rjafari44/Wall-Climber-Robot/cadFiles/frame.stl

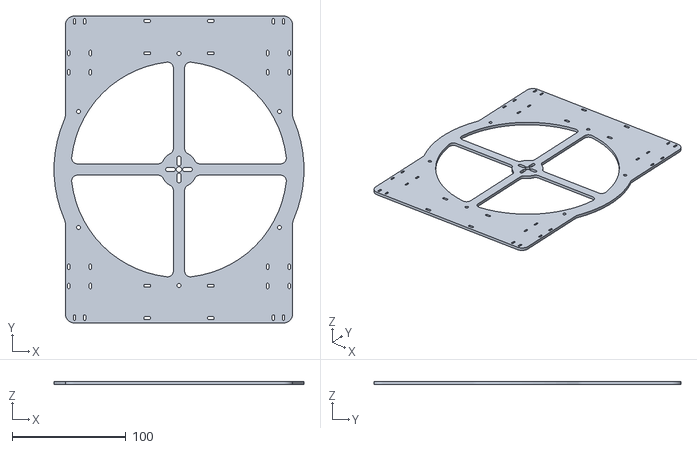
[picture p4: CAD file, 2026-03-28]
cadFiles/frame.stl
220.0 x 270.0 x 3.00
