rjafari44/Wall-Climber-Robot/cadFiles/shroud.stl

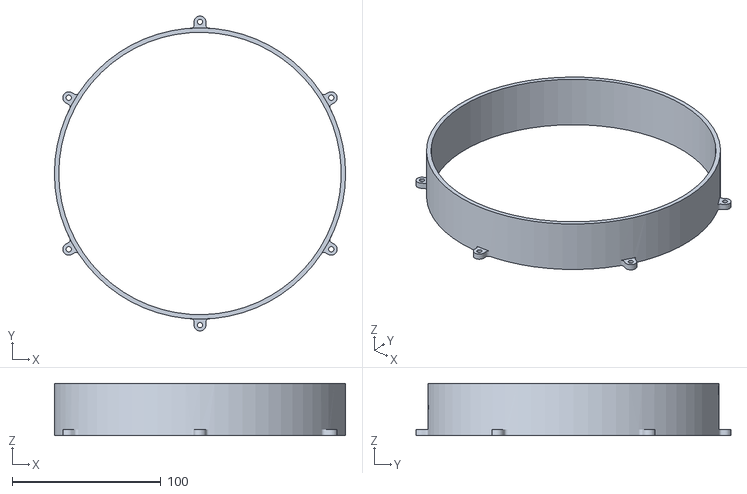
[picture p5: CAD file, 2026-03-28]
cadFiles/shroud.stl
196.0 x 212.0 x 35.0
